gom9000/eeprom-28C-programmer/resources/eeprom-28C-programmer_usage.jpg

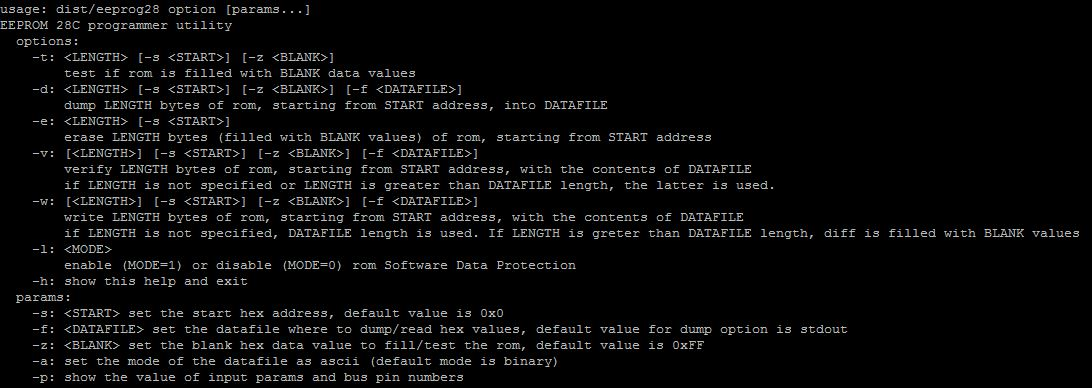
resources/eeprom-28C-programmer_usage.jpg
