gom9000/eeprom-28C-programmer/software/src/eeprom.h

/*
 * eeprom.h
 *
 *  ___ ___ ___ ___  ___  __  __                                                     
 * | __| __| _ \ _ \/ _ \|  \/  |___ _ __ _ _ ___  __ _ _ _ __ _ _ __  _ __  ___ _ _ 
 * | _|| _||  _/   / (_) | |\/| |___| '_ \ '_/ _ \/ _` | '_/ _` | '  \| '  \/ -_) '_|
 * |___|___|_| |_|_\\___/|_|  |_|   | .__/_| \___/\__, |_| \__,_|_|_|_|_|_|_\___|_|  
 *                                  |_|           |___/                              
 *
 * Author.....: Alessandro Fraschetti (mail: gos95@gommagomma.net)
 * Target.....: RaspberryPI
 * Version....: 1.3 2026/10/03
 * Description: EEPROM 28C-family programmer utility
 * URL........: https://github.com/gom9000/xp-eeprom-28C-programmer
 * License....: this program is under the terms of MIT License
 * Module.....: header file of library module eeprom.c
 * Notes......:
 */


#ifndef EEPROM_H
#define EEPROM_H


#include <stdint.h>
#include <stdio.h>
typedef uint32_t address_t;
typedef uint32_t length_t;
typedef uint8_t data_t;


#define BUS_SIZE(bus) (sizeof(bus)/sizeof(bus[0]))
#define WRITE_TIMEOUT_US 20000 /* > max tWC (10ms) of the 28C family */
#define TBLC_WAIT_US 200       /* > tBLC (150us) byte load cycle time */
#define MAX_PAGE_SIZE 128
#define MAX_WRITE_ERRORS 16    /* abort programming after this many failures */


extern uint8_t D[8]; // D0-D7
extern uint8_t A[15]; // A0-A14
extern uint8_t CE;
extern uint8_t OE;
extern uint8_t WE;


void setup(void);
void setAddress(address_t);
void setData(data_t);
data_t getData(void);
void setDataBusDirection(unsigned char);
data_t readROM(address_t);
void writeROM(address_t, data_t);
int waitForWriteCycle(address_t, data_t);
length_t programROM(address_t, const data_t*, length_t, length_t);
length_t eraseROM(address_t, length_t, data_t, length_t);
length_t verifyROM(address_t, const data_t*, length_t);
length_t testROM(address_t, length_t, data_t);
void dumpROM(address_t, length_t, FILE*, unsigned char);
void setSDPMode(unsigned char);


#endif /* !defined(EEPROM_H) */
